robtacconelli/kobra-x-bed-interceptor/images/esp32-wroom-32.jpg

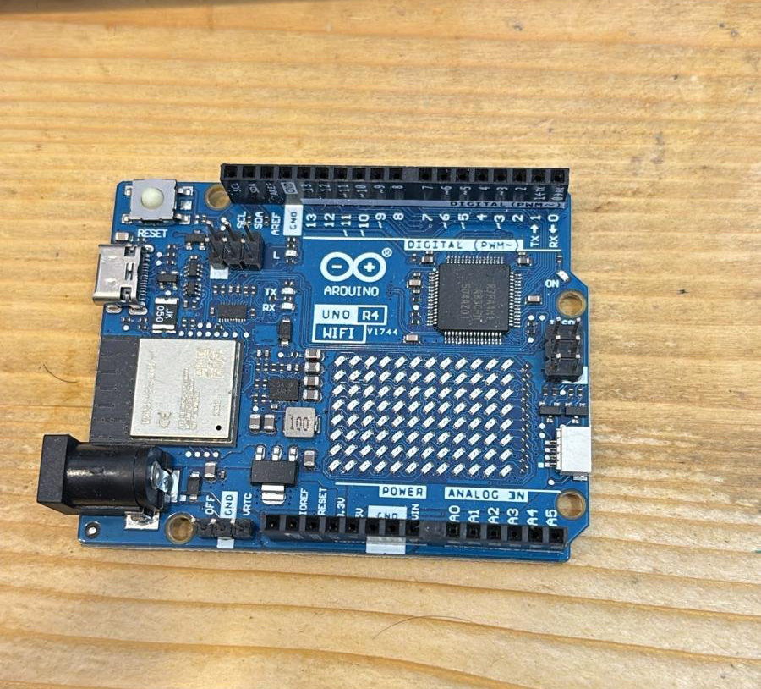
images/esp32-wroom-32.jpg
