robtacconelli/kobra-x-bed-interceptor/images/psu-board-overview.jpg

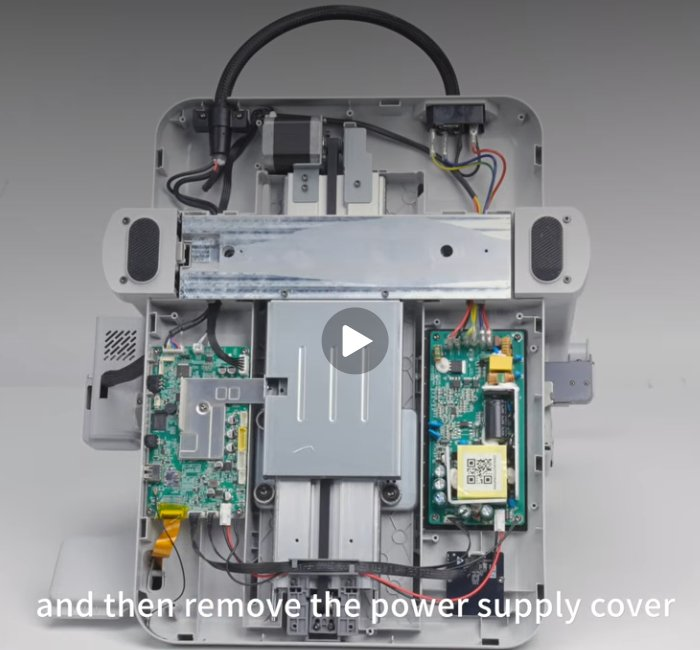
images/psu-board-overview.jpg
